brandonbraun653/DroneController/hw/Fusion360/TestPlateV1.stl

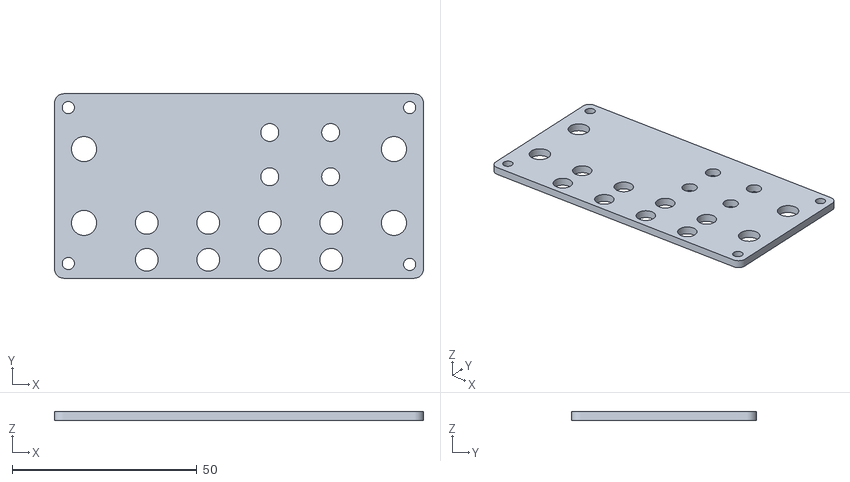
[picture p1: CAD file, 2021-05-23]
hw/Fusion360/TestPlateV1.stl
100.0 x 50.0 x 2.50
