brandonbraun653/DroneController/hw/PCBDesign/DroneController.kicad_pcb

## KiCad design hw/PCBDesign/DroneController.kicad_pcb (2021-12-31)

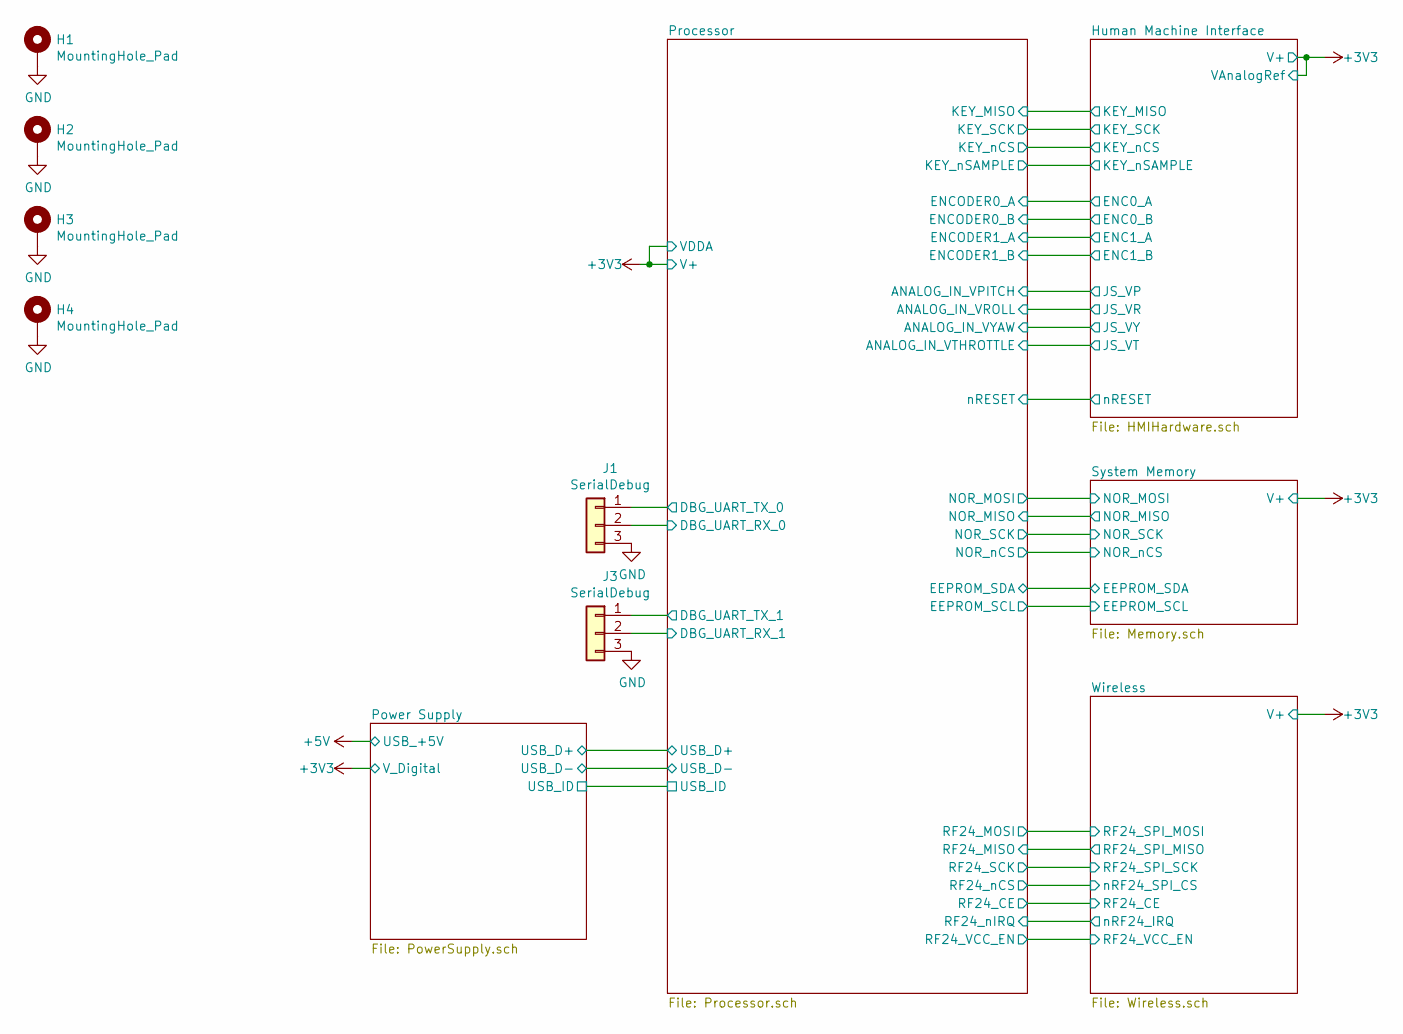
[picture p2: schematic DroneController.sch]

Parts:
H1, H2, H3, H4: MountingHole_Pad; MountingHole_3.2mm_M3_Pad_Via
J1, J3: SerialDebug; Molex_PicoBlade_53261-0371_1x03-1MP_P1.25mm_Horizontal; DigiKey WM7621CT-ND

Connections:
/Processor/DBG_UART_RX_0: J1.2; also elsewhere on the board
/Processor/DBG_UART_RX_1: J3.2; also elsewhere on the board
/Processor/DBG_UART_TX_0: J1.1; also elsewhere on the board
/Processor/DBG_UART_TX_1: J3.1; also elsewhere on the board
GND: H1.1, H2.1, H3.1, H4.1, J1.3, J3.3; also elsewhere on the board

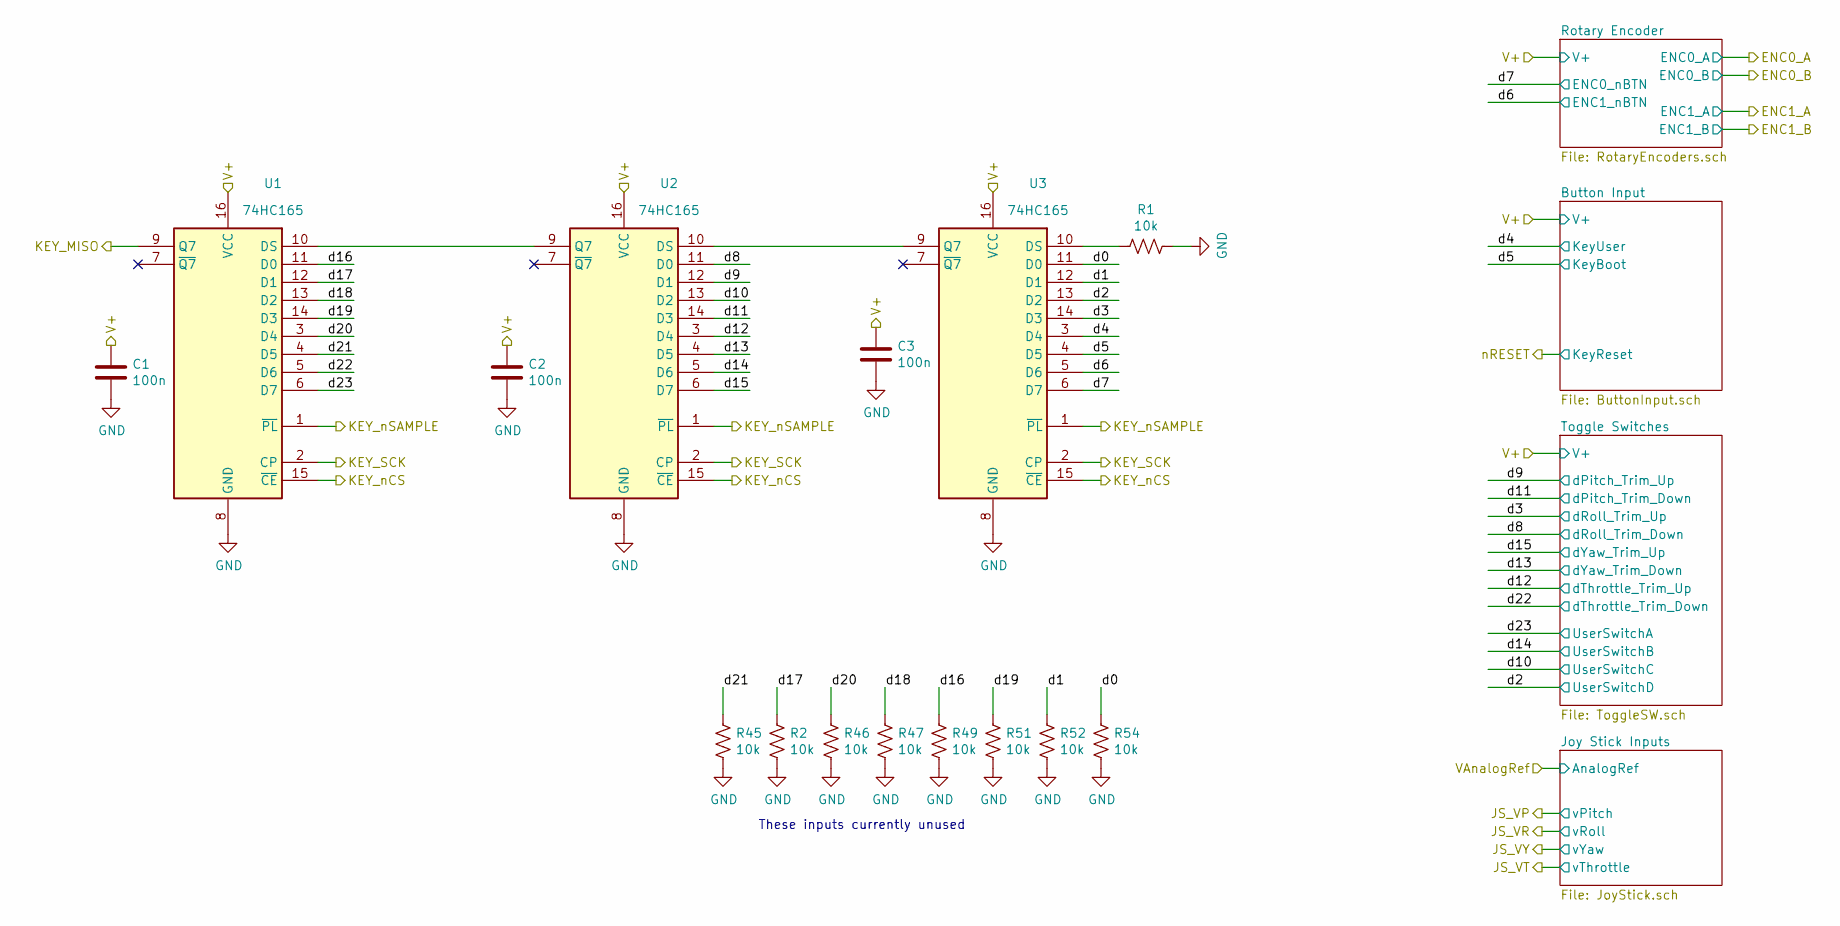
[picture p3: schematic HMIHardware.sch]

Parts:
C1, C2, C3: 100n; C_0402_1005Metric; LCSC C1525
R1, R2, R45, R46, R47, R49, R51, R52, R54: 10k; R_0402_1005Metric; LCSC C25744
U1, U2, U3: 74HC165; SOIC-16_3.9x9.9mm_P1.27mm; LCSC C5613

Connections:
+3V3: C1.1, C2.1, C3.1, U1.16 (VCC), U2.16 (VCC), U3.16 (VCC); also elsewhere on the board
/Human Machine Interface/KEY_MISO: U1.9 (Q7); also elsewhere on the board
/Human Machine Interface/KEY_SCK: U1.2 (CP), U2.2 (CP), U3.2 (CP); also elsewhere on the board
/Human Machine Interface/KEY_nCS: U1.15 (~CE), U2.15 (~CE), U3.15 (~CE); also elsewhere on the board
/Human Machine Interface/KEY_nSAMPLE: U1.1 (~PL), U2.1 (~PL), U3.1 (~PL); also elsewhere on the board
/Human Machine Interface/d0: R54.1, U3.11 (D0)
/Human Machine Interface/d1: R52.1, U3.12 (D1)
/Human Machine Interface/d2: U3.13 (D2); also elsewhere on the board
/Human Machine Interface/d3: U3.14 (D3); also elsewhere on the board
/Human Machine Interface/d4: U3.3 (D4); also elsewhere on the board
/Human Machine Interface/d5: U3.4 (D5); also elsewhere on the board
/Human Machine Interface/d6: U3.5 (D6); also elsewhere on the board
/Human Machine Interface/d7: U3.6 (D7); also elsewhere on the board
/Human Machine Interface/d8: U2.11 (D0); also elsewhere on the board
/Human Machine Interface/d9: U2.12 (D1); also elsewhere on the board
/Human Machine Interface/d10: U2.13 (D2); also elsewhere on the board
/Human Machine Interface/d11: U2.14 (D3); also elsewhere on the board
/Human Machine Interface/d12: U2.3 (D4); also elsewhere on the board
/Human Machine Interface/d13: U2.4 (D5); also elsewhere on the board
/Human Machine Interface/d14: U2.5 (D6); also elsewhere on the board
/Human Machine Interface/d15: U2.6 (D7); also elsewhere on the board
/Human Machine Interface/d16: R49.1, U1.11 (D0)
/Human Machine Interface/d17: R2.1, U1.12 (D1)
/Human Machine Interface/d18: R47.1, U1.13 (D2)
/Human Machine Interface/d19: R51.1, U1.14 (D3)
/Human Machine Interface/d20: R46.1, U1.3 (D4)
/Human Machine Interface/d21: R45.1, U1.4 (D5)
/Human Machine Interface/d22: U1.5 (D6); also elsewhere on the board
/Human Machine Interface/d23: U1.6 (D7); also elsewhere on the board
GND: C1.2, C2.2, C3.2, R1.2, R2.2, R45.2, R46.2, R47.2, R49.2, R51.2, R52.2, R54.2, U1.8 (GND), U2.8 (GND), U3.8 (GND); also elsewhere on the board
unnamed: R1.1, U3.10 (DS)
unnamed: U1.10 (DS), U2.9 (Q7)
unnamed: U2.10 (DS), U3.9 (Q7)

Notes on the sheet:
These inputs currently unused

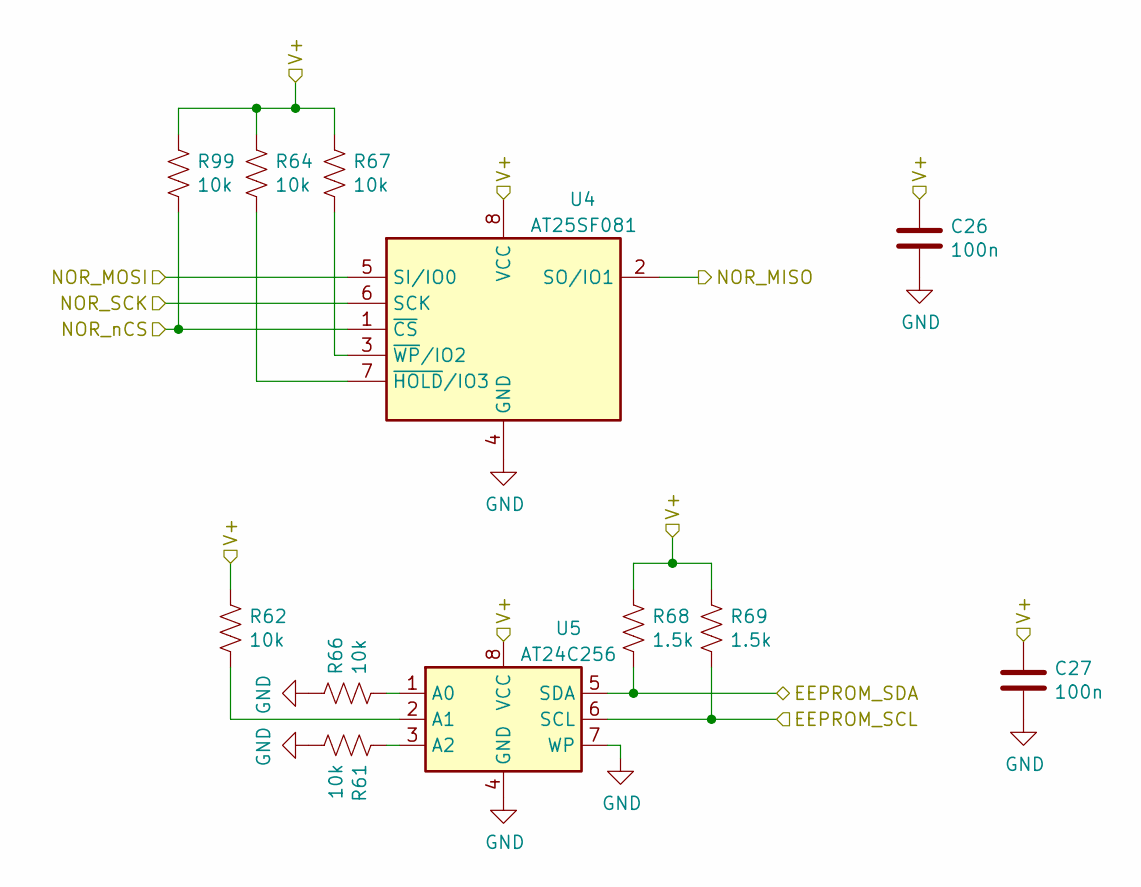
[picture p4: schematic Memory.sch]

Parts:
C26, C27: 100n; C_0402_1005Metric; LCSC C1525
R61, R62, R64, R66, R67, R99: 10k; R_0402_1005Metric; LCSC C25744
R68, R69: 1.5k; R_0402_1005Metric; LCSC C25867
U4: AT25SF081; SOIC-8_3.9x4.9mm_P1.27mm
U5: AT24C256; SOIC-8_3.9x4.9mm_P1.27mm; LCSC C6482

Connections:
+3V3: C26.1, C27.1, R62.1, R64.1, R67.1, R68.1, R69.1, R99.1, U4.8 (VCC), U5.8 (VCC); also elsewhere on the board
/Processor/EEPROM_SCL: R69.2, U5.6 (SCL); also elsewhere on the board
/Processor/EEPROM_SDA: R68.2, U5.5 (SDA); also elsewhere on the board
/Processor/NOR_MISO: U4.2 (SO/IO1); also elsewhere on the board
/Processor/NOR_MOSI: U4.5 (SI/IO0); also elsewhere on the board
/Processor/NOR_SCK: U4.6 (SCK); also elsewhere on the board
/Processor/NOR_nCS: R99.2, U4.1 (~CS); also elsewhere on the board
GND: C26.2, C27.2, R61.2, R66.1, U4.4 (GND), U5.4 (GND), U5.7 (WP); also elsewhere on the board
unnamed: R61.1, U5.3 (A2)
unnamed: R62.2, U5.2 (A1)
unnamed: R64.2, U4.7 (~HOLD~/IO3)
unnamed: R66.2, U5.1 (A0)
unnamed: R67.2, U4.3 (~WP~/IO2)

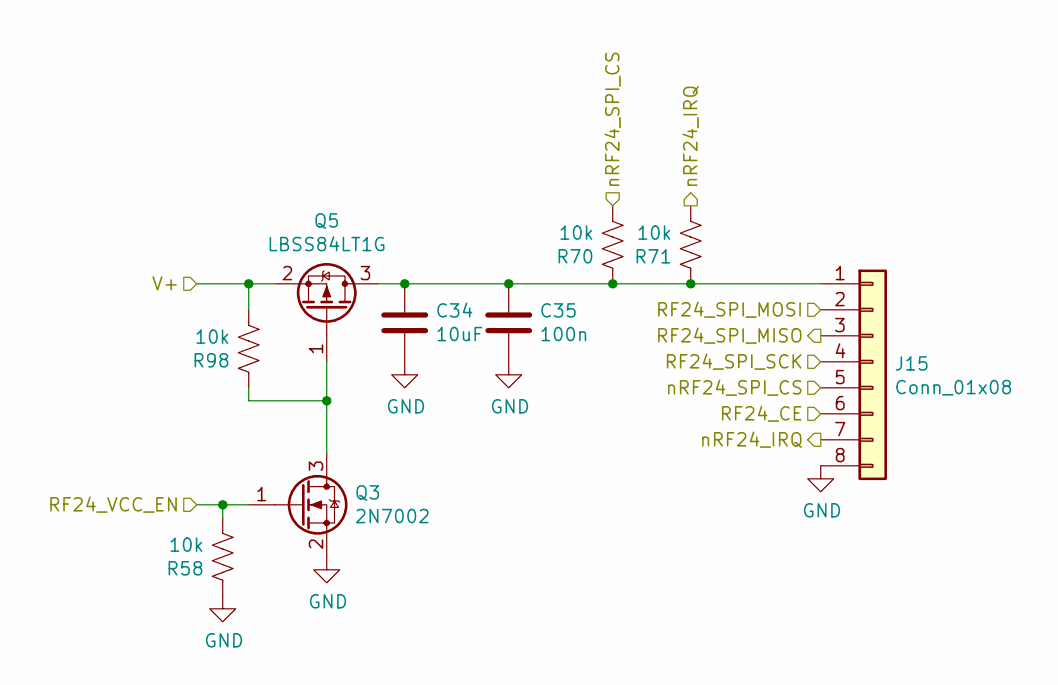
[picture p5: schematic Wireless.sch]

Parts:
C34: 10uF; C_0805_2012Metric; LCSC C28323
C35: 100n; C_0402_1005Metric; LCSC C1525
J15: Conn_01x08; Molex_PicoBlade_53261-0871_1x08-1MP_P1.25mm_Horizontal; DigiKey WM26501CT-ND
Q3: 2N7002; SOT-23; LCSC C8545
Q5: LBSS84LT1G; SOT-23; LCSC C8492
R58, R70, R71, R98: 10k; R_0402_1005Metric; LCSC C25744

Connections:
+3V3: Q5.2 (S), R98.2; also elsewhere on the board
/Processor/RF24_CE: J15.6; also elsewhere on the board
/Processor/RF24_MISO: J15.3; also elsewhere on the board
/Processor/RF24_MOSI: J15.2; also elsewhere on the board
/Processor/RF24_SCK: J15.4; also elsewhere on the board
/Processor/RF24_VCC_EN: Q3.1 (G), R58.2; also elsewhere on the board
/Processor/RF24_nCS: J15.5, R70.2; also elsewhere on the board
/Processor/RF24_nIRQ: J15.7, R71.2; also elsewhere on the board
GND: C34.2, C35.2, J15.8, Q3.2 (S), R58.1; also elsewhere on the board
unnamed: C34.1, C35.1, J15.1, Q5.3 (D), R70.1, R71.1
unnamed: Q3.3 (D), Q5.1 (G), R98.1

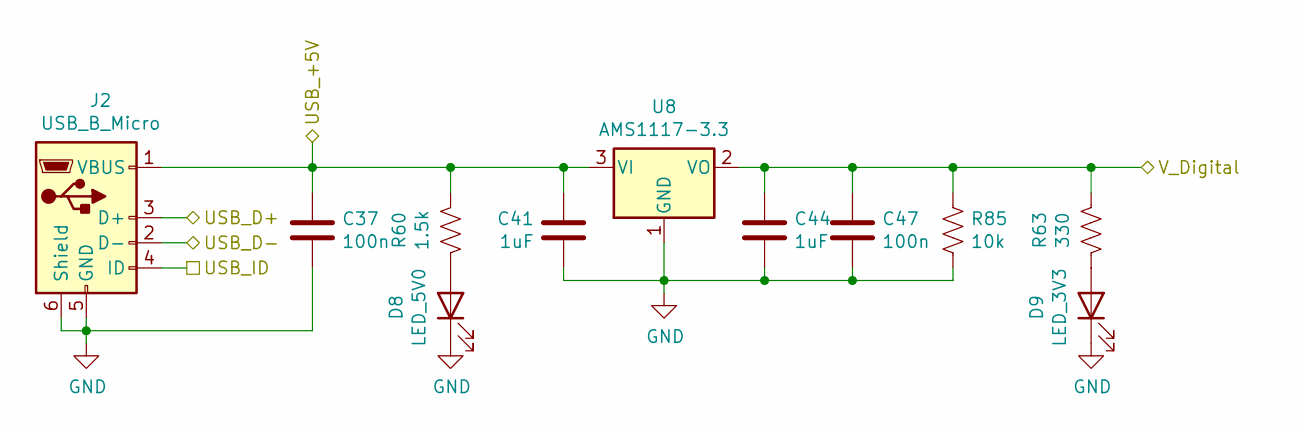
[picture p6: schematic PowerSupply.sch]

Parts:
C37, C47: 100n; C_0402_1005Metric; LCSC C1525
C41, C44: 1uF; C_0805_2012Metric; LCSC C28323
D8: LED_5V0; LED_0402_1005Metric; LCSC C72043
D9: LED_3V3; LED_0402_1005Metric; LCSC C72041
J2: USB_B_Micro; Amphenol-MicroB; DigiKey 609-4616-2-ND
R60: 1.5k; R_0402_1005Metric; LCSC C25867
R63: 330; R_0402_1005Metric; LCSC C25104
R85: 10k; R_0402_1005Metric; LCSC C25744
U8: AMS1117-3.3; SOT-223-3_TabPin2; LCSC C6186

Connections:
+3V3: C44.1, C47.1, R63.2, R85.1, U8.2 (VO); also elsewhere on the board
+5V: C37.1, C41.2, J2.1 (VBUS), R60.2, U8.3 (VI); also elsewhere on the board
/Power Supply/USB_D+: J2.3 (D+); also elsewhere on the board
/Power Supply/USB_D-: J2.2 (D-); also elsewhere on the board
/Power Supply/USB_ID: J2.4 (ID); also elsewhere on the board
GND: C37.2, C41.1, C44.2, C47.2, D8.1 (K), D9.1 (K), J2.5 (GND), J2.6 (Shield), R85.2, U8.1 (GND); also elsewhere on the board
unnamed: D8.2 (A), R60.1
unnamed: D9.2 (A), R63.1

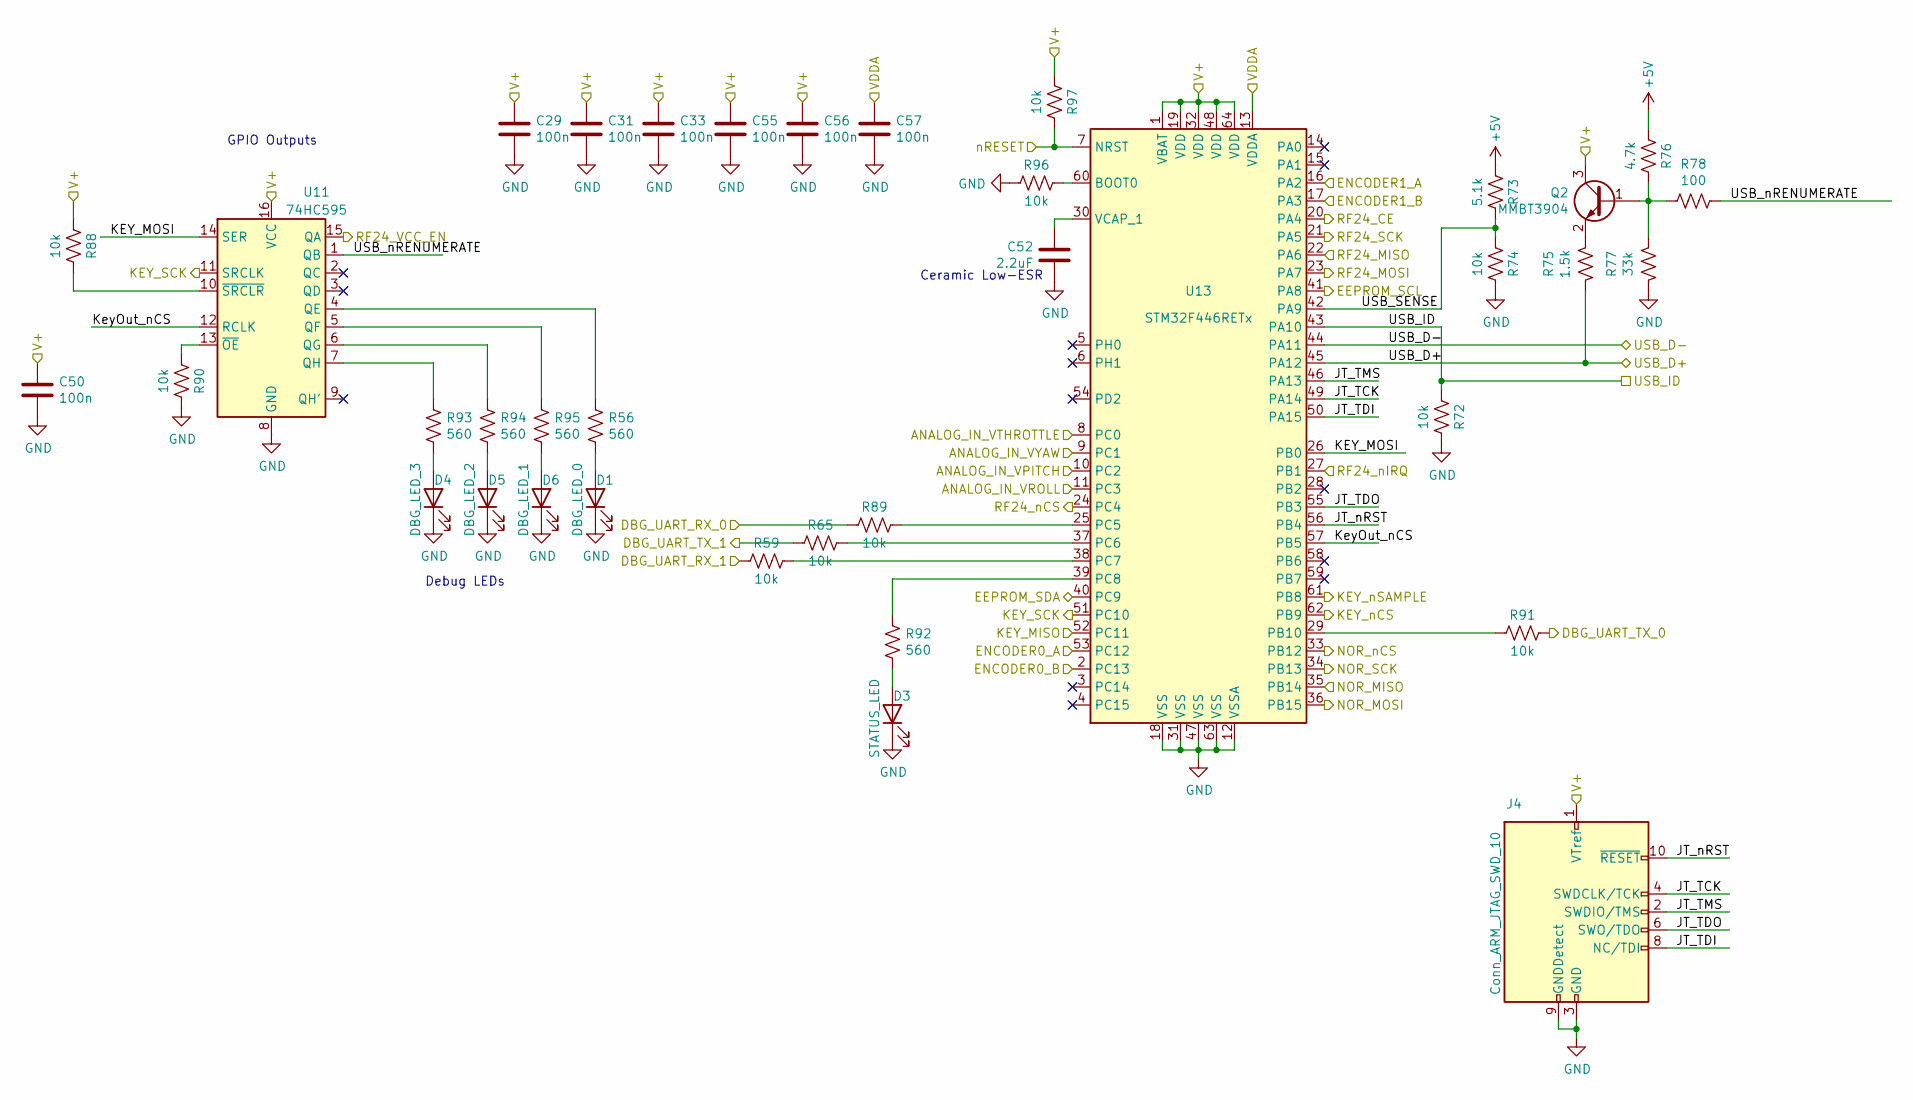
[picture p7: schematic Processor.sch]

Parts:
C29, C31, C33, C50, C55, C56, C57: 100n; C_0402_1005Metric; LCSC C1525
C52: 2.2uF; C_0805_2012Metric; LCSC C49217
D1: DBG_LED_0; LED_0603_1608Metric; LCSC C72041
D3: STATUS_LED; LED_0603_1608Metric; LCSC C72041
D4: DBG_LED_3; LED_0603_1608Metric; LCSC C72041
D5: DBG_LED_2; LED_0603_1608Metric; LCSC C72041
D6: DBG_LED_1; LED_0603_1608Metric; LCSC C72041
J4: Conn_ARM_JTAG_SWD_10; PinHeader_2x05_P1.27mm_Vertical_SMD; DigiKey 609-3695-1-ND
Q2: MMBT3904; SOT-23; LCSC C20526
R56, R92, R93, R94, R95: 560; R_0402_1005Metric; LCSC C11702
R59, R65, R72, R74, R88, R89, R90, R91, R96, R97: 10k; R_0402_1005Metric; LCSC C25744
R73: 5.1k; R_0402_1005Metric; LCSC C25905
R75: 1.5k; R_0402_1005Metric; LCSC C25867
R76: 4.7k; R_0402_1005Metric; LCSC C25900
R77: 33k; R_0402_1005Metric; LCSC C25779
R78: 100; R_0402_1005Metric; LCSC C25076
U11: 74HC595; SO-16_3.9x9.9mm_P1.27mm; LCSC C5947
U13: STM32F446RETx; LQFP-64_10x10mm_P0.5mm; LCSC C69336

Connections:
+3V3: C29.1, C31.1, C33.1, C50.1, C55.1, C56.1, C57.1, J4.1 (VTref), Q2.3 (C), R88.2, R97.2, U11.16 (VCC), U13.1 (VBAT), U13.13 (VDDA), U13.19 (VDD), U13.32 (VDD), U13.48 (VDD), U13.64 (VDD); also elsewhere on the board
+5V: R73.2, R76.2; also elsewhere on the board
/Human Machine Interface/ENC0_A: U13.53 (PC12); also elsewhere on the board
/Human Machine Interface/ENC0_B: U13.2 (PC13); also elsewhere on the board
/Human Machine Interface/ENC1_A: U13.16 (PA2); also elsewhere on the board
/Human Machine Interface/ENC1_B: U13.17 (PA3); also elsewhere on the board
/Human Machine Interface/KEY_MISO: U13.52 (PC11); also elsewhere on the board
/Human Machine Interface/KEY_SCK: U11.11 (SRCLK), U13.51 (PC10); also elsewhere on the board
/Human Machine Interface/KEY_nCS: U13.62 (PB9); also elsewhere on the board
/Human Machine Interface/KEY_nSAMPLE: U13.61 (PB8); also elsewhere on the board
/Human Machine Interface/nRESET: R97.1, U13.7 (NRST); also elsewhere on the board
/Power Supply/USB_D+: R75.1, U13.45 (PA12); also elsewhere on the board
/Power Supply/USB_D-: U13.44 (PA11); also elsewhere on the board
/Power Supply/USB_ID: R72.2, U13.43 (PA10); also elsewhere on the board
/Processor/ANALOG_IN_VPITCH: U13.10 (PC2); also elsewhere on the board
/Processor/ANALOG_IN_VROLL: U13.11 (PC3); also elsewhere on the board
/Processor/ANALOG_IN_VTHROTTLE: U13.8 (PC0); also elsewhere on the board
/Processor/ANALOG_IN_VYAW: U13.9 (PC1); also elsewhere on the board
/Processor/DBG_UART_RX_0: R89.2; also elsewhere on the board
/Processor/DBG_UART_RX_1: R59.2; also elsewhere on the board
/Processor/DBG_UART_TX_0: R91.1; also elsewhere on the board
/Processor/DBG_UART_TX_1: R65.2; also elsewhere on the board
/Processor/EEPROM_SCL: U13.41 (PA8); also elsewhere on the board
/Processor/EEPROM_SDA: U13.40 (PC9); also elsewhere on the board
/Processor/JT_TCK: J4.4 (SWDCLK/TCK), U13.49 (PA14)
/Processor/JT_TDI: J4.8 (NC/TDI), U13.50 (PA15)
/Processor/JT_TDO: J4.6 (SWO/TDO), U13.55 (PB3)
/Processor/JT_TMS: J4.2 (SWDIO/TMS), U13.46 (PA13)
/Processor/JT_nRST: J4.10 (~RESET~), U13.56 (PB4)
/Processor/KEY_MOSI: U11.14 (SER), U13.26 (PB0)
/Processor/KeyOut_nCS: U11.12 (RCLK), U13.57 (PB5)
/Processor/NOR_MISO: U13.35 (PB14); also elsewhere on the board
/Processor/NOR_MOSI: U13.36 (PB15); also elsewhere on the board
/Processor/NOR_SCK: U13.34 (PB13); also elsewhere on the board
/Processor/NOR_nCS: U13.33 (PB12); also elsewhere on the board
/Processor/RF24_CE: U13.20 (PA4); also elsewhere on the board
/Processor/RF24_MISO: U13.22 (PA6); also elsewhere on the board
/Processor/RF24_MOSI: U13.23 (PA7); also elsewhere on the board
/Processor/RF24_SCK: U13.21 (PA5); also elsewhere on the board
/Processor/RF24_VCC_EN: U11.15 (QA); also elsewhere on the board
/Processor/RF24_nCS: U13.24 (PC4); also elsewhere on the board
/Processor/RF24_nIRQ: U13.27 (PB1); also elsewhere on the board
/Processor/USB_SENSE: R73.1, R74.2, U13.42 (PA9)
/Processor/USB_nRENUMERATE: R78.1, U11.1 (QB)
GND: C29.2, C31.2, C33.2, C50.2, C52.1, C55.2, C56.2, C57.2, D1.1 (K), D3.1 (K), D4.1 (K), D5.1 (K), D6.1 (K), J4.3 (GND), J4.5 (GND), J4.9 (GNDDetect), R72.1, R74.1, R77.1, R90.1, R96.2, U11.8 (GND), U13.12 (VSSA), U13.18 (VSS), U13.31 (VSS), U13.47 (VSS), U13.63 (VSS); also elsewhere on the board
unnamed: C52.2, U13.30 (VCAP_1)
unnamed: D1.2 (A), R56.1
unnamed: D3.2 (A), R92.1
unnamed: D4.2 (A), R93.1
unnamed: D5.2 (A), R94.1
unnamed: D6.2 (A), R95.1
unnamed: Q2.1 (B), R76.1, R77.2, R78.2
unnamed: Q2.2 (E), R75.2
unnamed: R56.2, U11.4 (QE)
unnamed: R59.1, U13.38 (PC7)
unnamed: R65.1, U13.37 (PC6)
unnamed: R88.1, U11.10 (~SRCLR)
unnamed: R89.1, U13.25 (PC5)
unnamed: R90.2, U11.13 (~OE)
unnamed: R91.2, U13.29 (PB10)
unnamed: R92.2, U13.39 (PC8)
unnamed: R93.2, U11.7 (QH)
unnamed: R94.2, U11.6 (QG)
unnamed: R95.2, U11.5 (QF)
unnamed: R96.1, U13.60 (BOOT0)

Notes on the sheet:
Ceramic Low-ESR
GPIO Outputs
Debug LEDs

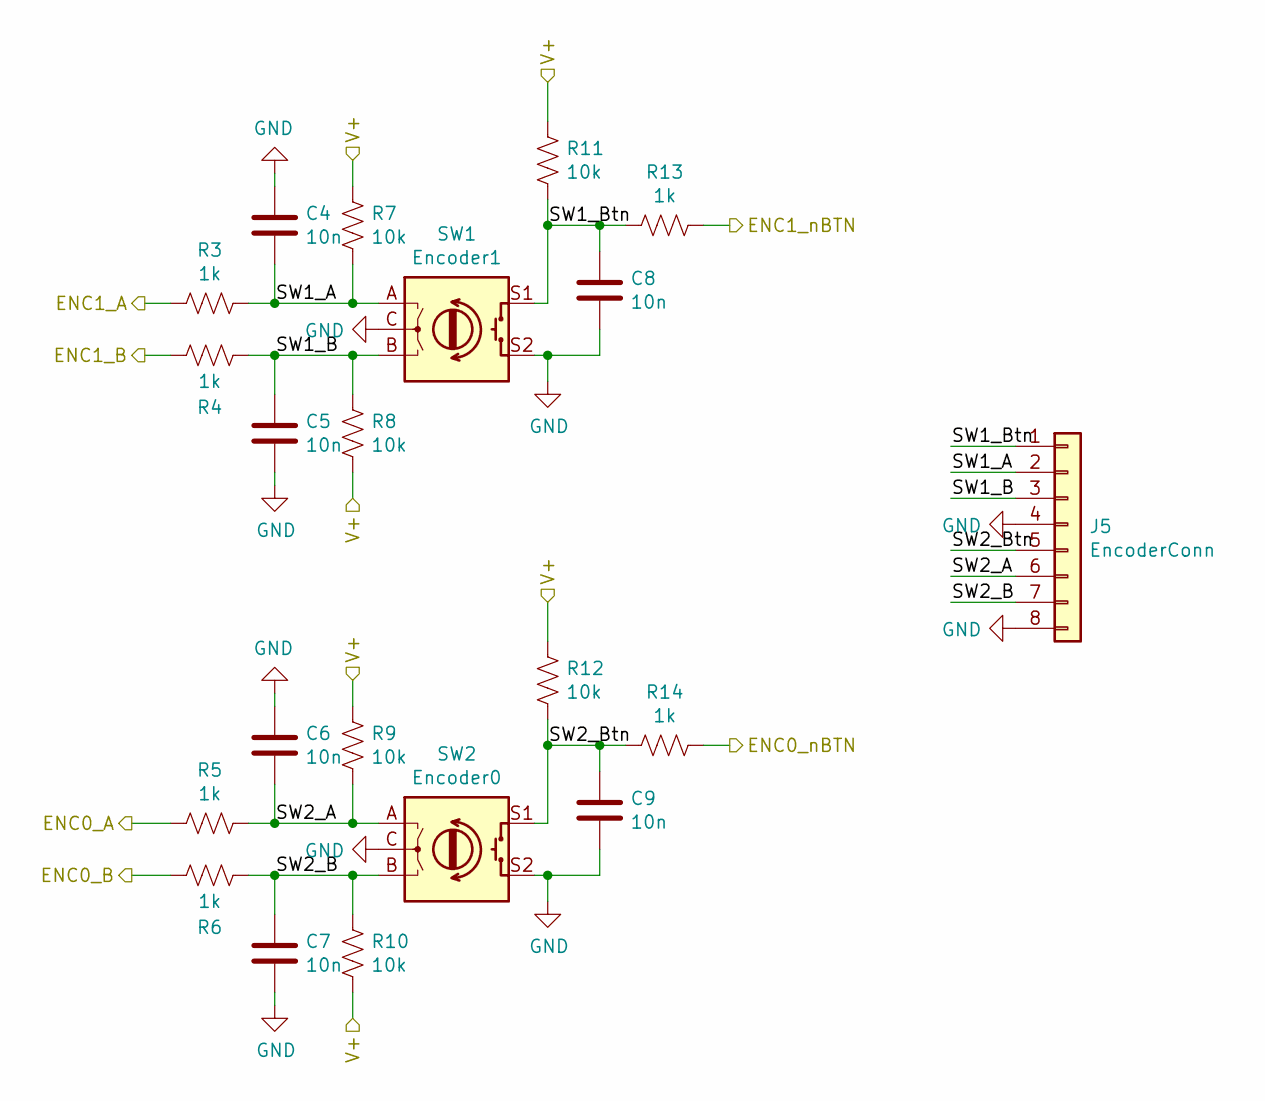
[picture p8: schematic RotaryEncoders.sch]

Parts:
C4, C5, C6, C7, C8, C9: 10n; C_0402_1005Metric; LCSC C15195
J5: EncoderConn; Molex_PicoBlade_53261-0871_1x08-1MP_P1.25mm_Horizontal; DigiKey WM26501CT-ND
R3, R4, R5, R6, R13, R14: 1k; R_0402_1005Metric; LCSC C11702
R7, R8, R9, R10, R11, R12: 10k; R_0402_1005Metric; LCSC C25744
SW1: Encoder1
SW2: Encoder0

Connections:
+3V3: R7.1, R8.2, R9.1, R10.2, R11.1, R12.1; also elsewhere on the board
/Human Machine Interface/ENC0_A: R5.2; also elsewhere on the board
/Human Machine Interface/ENC0_B: R6.2; also elsewhere on the board
/Human Machine Interface/ENC1_A: R3.2; also elsewhere on the board
/Human Machine Interface/ENC1_B: R4.2; also elsewhere on the board
/Human Machine Interface/Rotary Encoder/SW1_A: C4.2, J5.2, R3.1, R7.2, SW1.A
/Human Machine Interface/Rotary Encoder/SW1_B: C5.1, J5.3, R4.1, R8.1, SW1.B
/Human Machine Interface/Rotary Encoder/SW1_Btn: C8.1, J5.1, R11.2, R13.2, SW1.S1
/Human Machine Interface/Rotary Encoder/SW2_A: C6.2, J5.6, R5.1, R9.2, SW2.A
/Human Machine Interface/Rotary Encoder/SW2_B: C7.1, J5.7, R6.1, R10.1, SW2.B
/Human Machine Interface/Rotary Encoder/SW2_Btn: C9.1, J5.5, R12.2, R14.2, SW2.S1
/Human Machine Interface/d6: R13.1; also elsewhere on the board
/Human Machine Interface/d7: R14.1; also elsewhere on the board
GND: C4.1, C5.2, C6.1, C7.2, C8.2, C9.2, J5.4, J5.8, SW1.C, SW1.S2, SW2.C, SW2.S2; also elsewhere on the board

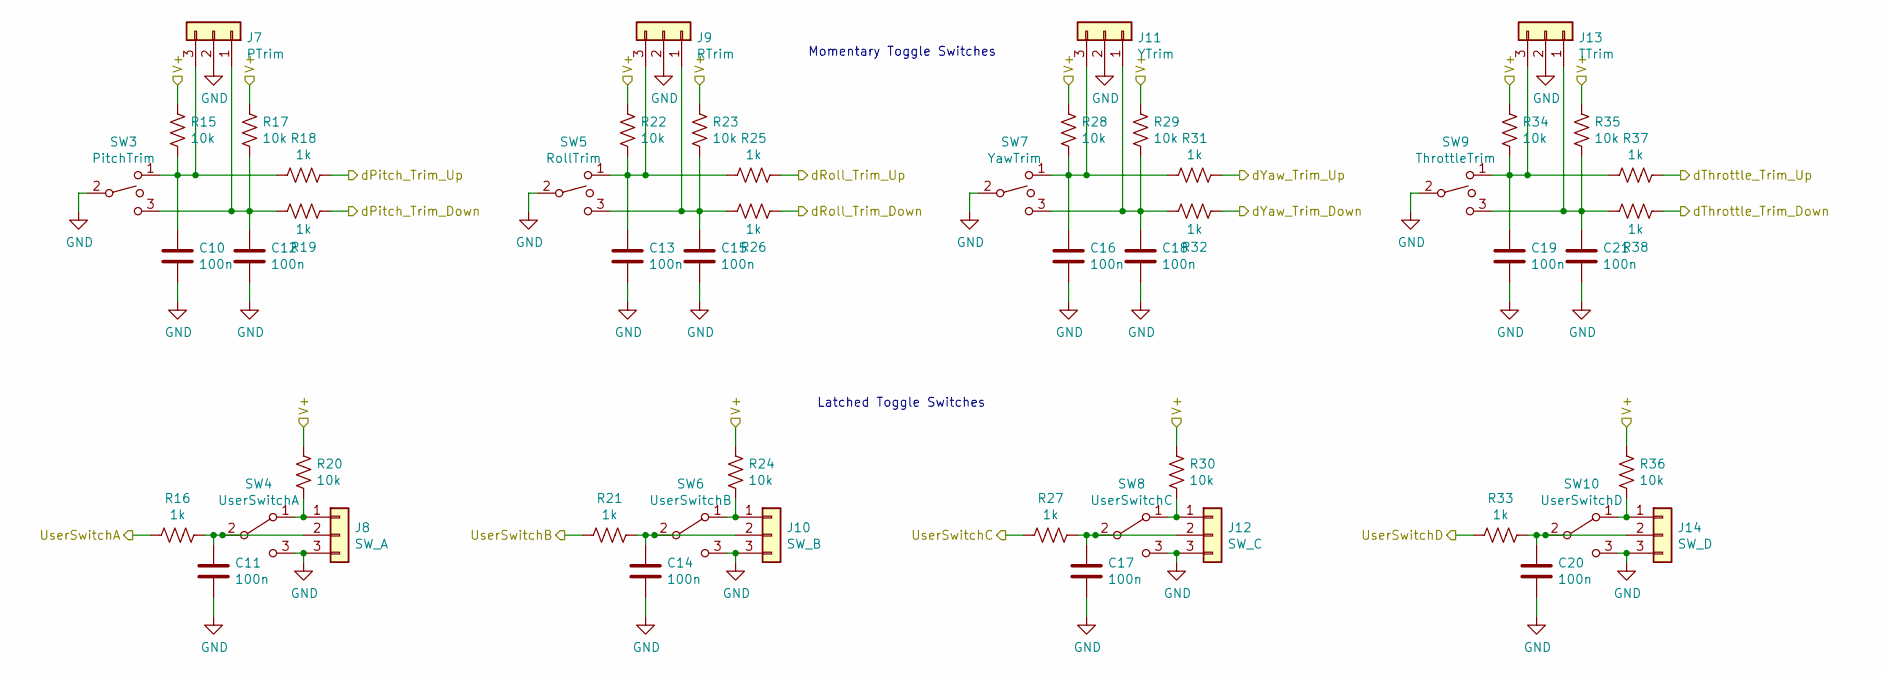
[picture p9: schematic ToggleSW.sch]

Parts:
C10, C11, C12, C13, C14, C15, C16, C17, C18, C19, C20, C21: 100n; C_0402_1005Metric; LCSC C1525
J7: PTrim; Molex_PicoBlade_53261-0371_1x03-1MP_P1.25mm_Horizontal; DigiKey WM7621CT-ND
J8: SW_A; Molex_PicoBlade_53261-0371_1x03-1MP_P1.25mm_Horizontal; DigiKey WM7621CT-ND
J9: RTrim; Molex_PicoBlade_53261-0371_1x03-1MP_P1.25mm_Horizontal; DigiKey WM7621CT-ND
J10: SW_B; Molex_PicoBlade_53261-0371_1x03-1MP_P1.25mm_Horizontal; DigiKey WM7621CT-ND
J11: YTrim; Molex_PicoBlade_53261-0371_1x03-1MP_P1.25mm_Horizontal; DigiKey WM7621CT-ND
J12: SW_C; Molex_PicoBlade_53261-0371_1x03-1MP_P1.25mm_Horizontal; DigiKey WM7621CT-ND
J13: TTrim; Molex_PicoBlade_53261-0371_1x03-1MP_P1.25mm_Horizontal; DigiKey WM7621CT-ND
J14: SW_D; Molex_PicoBlade_53261-0371_1x03-1MP_P1.25mm_Horizontal; DigiKey WM7621CT-ND
R15, R17, R20, R22, R23, R24, R28, R29, R30, R34, R35, R36: 10k; R_0402_1005Metric; LCSC C25744
R16, R18, R19, R21, R25, R26, R27, R31, R32, R33, R37, R38: 1k; R_0402_1005Metric; LCSC C11702
SW3: PitchTrim
SW4: UserSwitchA
SW5: RollTrim
SW6: UserSwitchB
SW7: YawTrim
SW8: UserSwitchC
SW9: ThrottleTrim
SW10: UserSwitchD

Connections:
+3V3: R15.1, R17.1, R20.1, R22.1, R23.1, R24.1, R28.1, R29.1, R30.1, R34.1, R35.1, R36.1; also elsewhere on the board
/Human Machine Interface/d2: R33.2; also elsewhere on the board
/Human Machine Interface/d3: R25.1; also elsewhere on the board
/Human Machine Interface/d8: R26.2; also elsewhere on the board
/Human Machine Interface/d9: R18.1; also elsewhere on the board
/Human Machine Interface/d10: R27.2; also elsewhere on the board
/Human Machine Interface/d11: R19.2; also elsewhere on the board
/Human Machine Interface/d12: R37.1; also elsewhere on the board
/Human Machine Interface/d13: R32.2; also elsewhere on the board
/Human Machine Interface/d14: R21.2; also elsewhere on the board
/Human Machine Interface/d15: R31.1; also elsewhere on the board
/Human Machine Interface/d22: R38.2; also elsewhere on the board
/Human Machine Interface/d23: R16.2; also elsewhere on the board
GND: C10.2, C11.2, C12.2, C13.2, C14.2, C15.2, C16.2, C17.2, C18.2, C19.2, C20.2, C21.2, J7.2, J8.3, J9.2, J10.3, J11.2, J12.3, J13.2, J14.3, SW3.2, SW4.3 (C), SW5.2, SW6.3 (C), SW7.2, SW8.3 (C), SW9.2, SW10.3 (C); also elsewhere on the board
unnamed: C10.1, J7.3, R15.2, R18.2, SW3.1
unnamed: C11.1, J8.2, R16.1, SW4.2 (B)
unnamed: C12.1, J7.1, R17.2, R19.1, SW3.3
unnamed: C13.1, J9.3, R22.2, R25.2, SW5.1
unnamed: C14.1, J10.2, R21.1, SW6.2 (B)
unnamed: C15.1, J9.1, R23.2, R26.1, SW5.3
unnamed: C16.1, J11.3, R28.2, R31.2, SW7.1
unnamed: C17.1, J12.2, R27.1, SW8.2 (B)
unnamed: C18.1, J11.1, R29.2, R32.1, SW7.3
unnamed: C19.1, J13.3, R34.2, R37.2, SW9.1
unnamed: C20.1, J14.2, R33.1, SW10.2 (B)
unnamed: C21.1, J13.1, R35.2, R38.1, SW9.3
unnamed: J8.1, R20.2, SW4.1 (A)
unnamed: J10.1, R24.2, SW6.1 (A)
unnamed: J12.1, R30.2, SW8.1 (A)
unnamed: J14.1, R36.2, SW10.1 (A)

Notes on the sheet:
Momentary Toggle Switches
Latched Toggle Switches

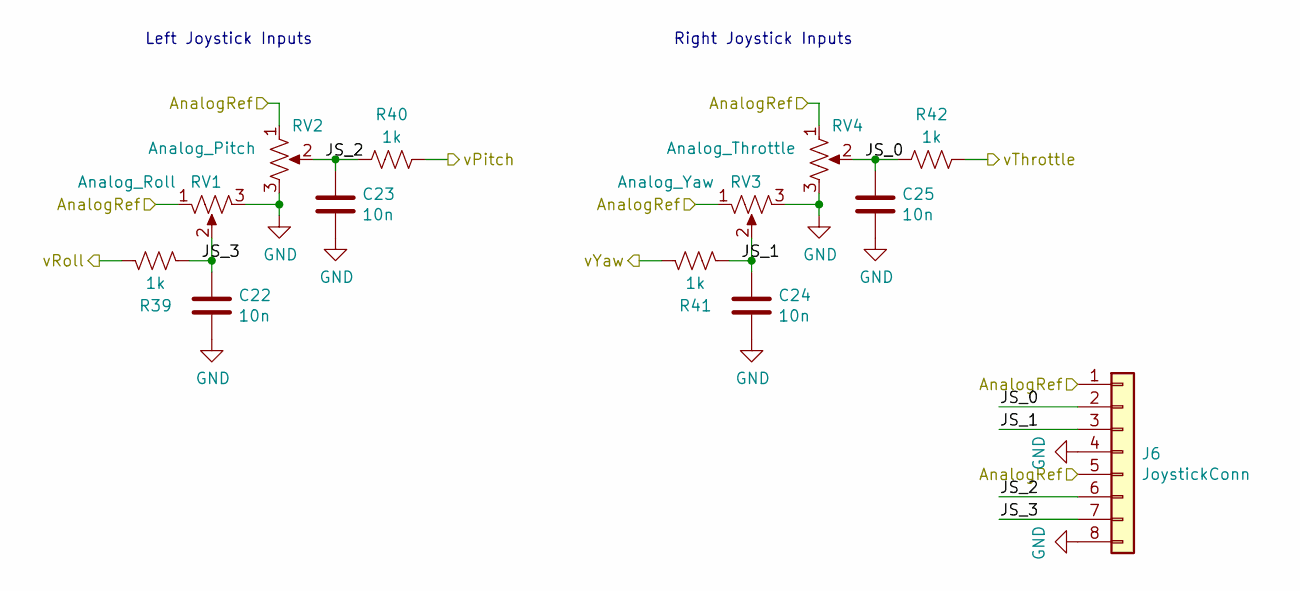
[picture p10: schematic JoyStick.sch]

Parts:
C22, C23, C24, C25: 10n; C_0402_1005Metric; LCSC C15195
J6: JoystickConn; Molex_PicoBlade_53261-0871_1x08-1MP_P1.25mm_Horizontal; DigiKey WM26501CT-ND
R39, R40, R41, R42: 1k; R_0402_1005Metric; LCSC C11702
RV1: Analog_Roll
RV2: Analog_Pitch
RV3: Analog_Yaw
RV4: Analog_Throttle

Connections:
+3V3: J6.1, J6.5, RV1.1, RV2.1, RV3.1, RV4.1; also elsewhere on the board
/Human Machine Interface/Joy Stick Inputs/JS_0: C25.1, J6.2, R42.1, RV4.2
/Human Machine Interface/Joy Stick Inputs/JS_1: C24.1, J6.3, R41.2, RV3.2
/Human Machine Interface/Joy Stick Inputs/JS_2: C23.1, J6.6, R40.1, RV2.2
/Human Machine Interface/Joy Stick Inputs/JS_3: C22.1, J6.7, R39.2, RV1.2
/Processor/ANALOG_IN_VPITCH: R40.2; also elsewhere on the board
/Processor/ANALOG_IN_VROLL: R39.1; also elsewhere on the board
/Processor/ANALOG_IN_VTHROTTLE: R42.2; also elsewhere on the board
/Processor/ANALOG_IN_VYAW: R41.1; also elsewhere on the board
GND: C22.2, C23.2, C24.2, C25.2, J6.4, J6.8, RV1.3, RV2.3, RV3.3, RV4.3; also elsewhere on the board

Notes on the sheet:
Left Joystick Inputs
Right Joystick Inputs

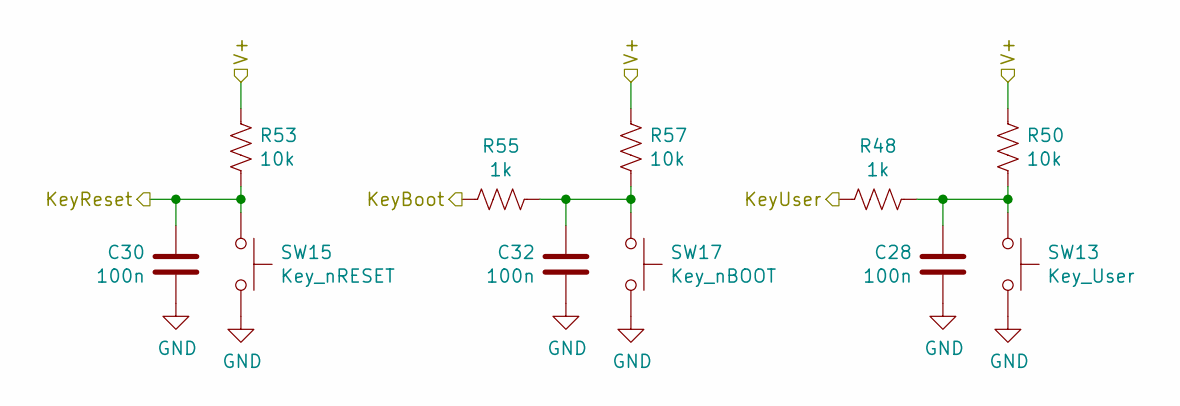
[picture p11: schematic ButtonInput.sch]

Parts:
C28, C30, C32: 100n; C_0402_1005Metric; LCSC C1525
R48, R55: 1k; R_0402_1005Metric; LCSC C11702
R50, R53, R57: 10k; R_0402_1005Metric; LCSC C25744
SW13: Key_User; SW_SPST_PTS810; DigiKey CKN10504CT-ND
SW15: Key_nRESET; SW_SPST_PTS810; DigiKey CKN10504CT-ND
SW17: Key_nBOOT; SW_SPST_PTS810; DigiKey CKN10504CT-ND

Connections:
+3V3: R50.1, R53.1, R57.1; also elsewhere on the board
/Human Machine Interface/d4: R48.2; also elsewhere on the board
/Human Machine Interface/d5: R55.2; also elsewhere on the board
/Human Machine Interface/nRESET: C30.2, R53.2, SW15.1; also elsewhere on the board
GND: C28.1, C30.1, C32.1, SW13.2, SW15.2, SW17.2; also elsewhere on the board
unnamed: C28.2, R48.1, R50.2, SW13.1
unnamed: C32.2, R55.1, R57.2, SW17.1
