brandonbraun653/DroneController/hw/PCBDesign/DroneController.kicad_pcb

## KiCad design hw/PCBDesign/DroneController.kicad_pcb (continued)

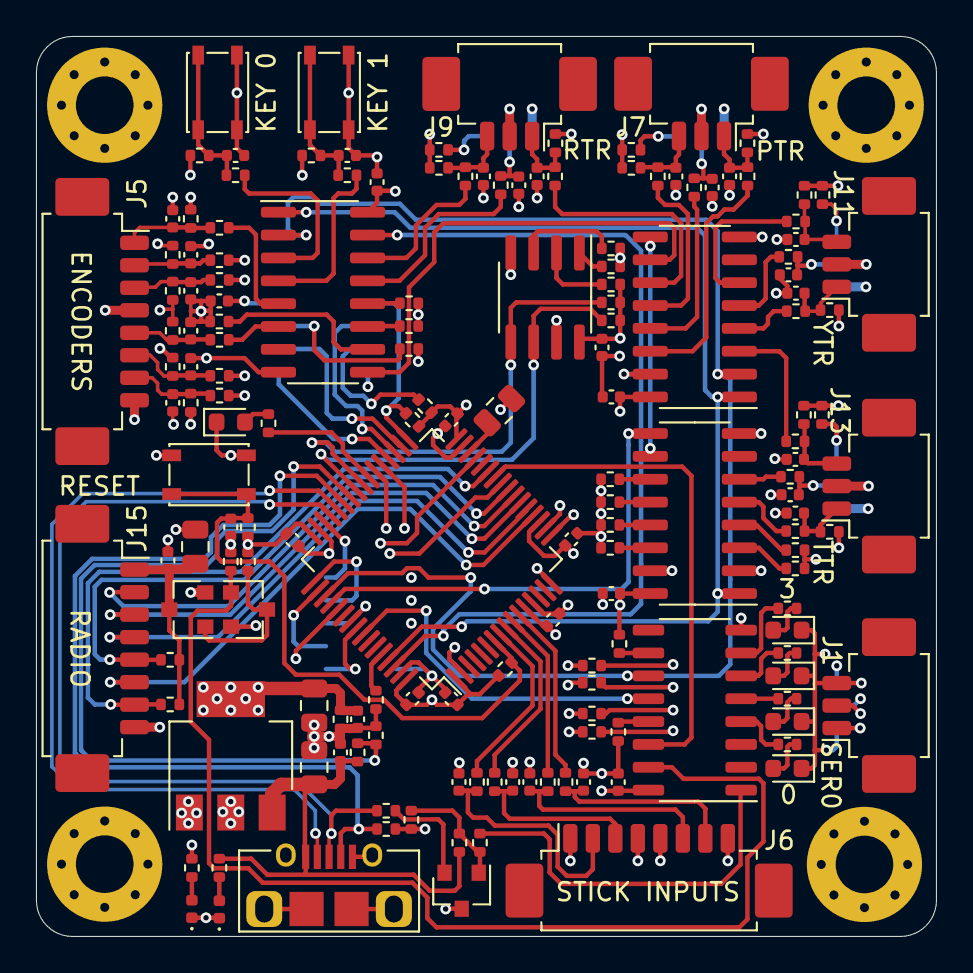
[picture p12: board DroneController.kicad_pcb from above]

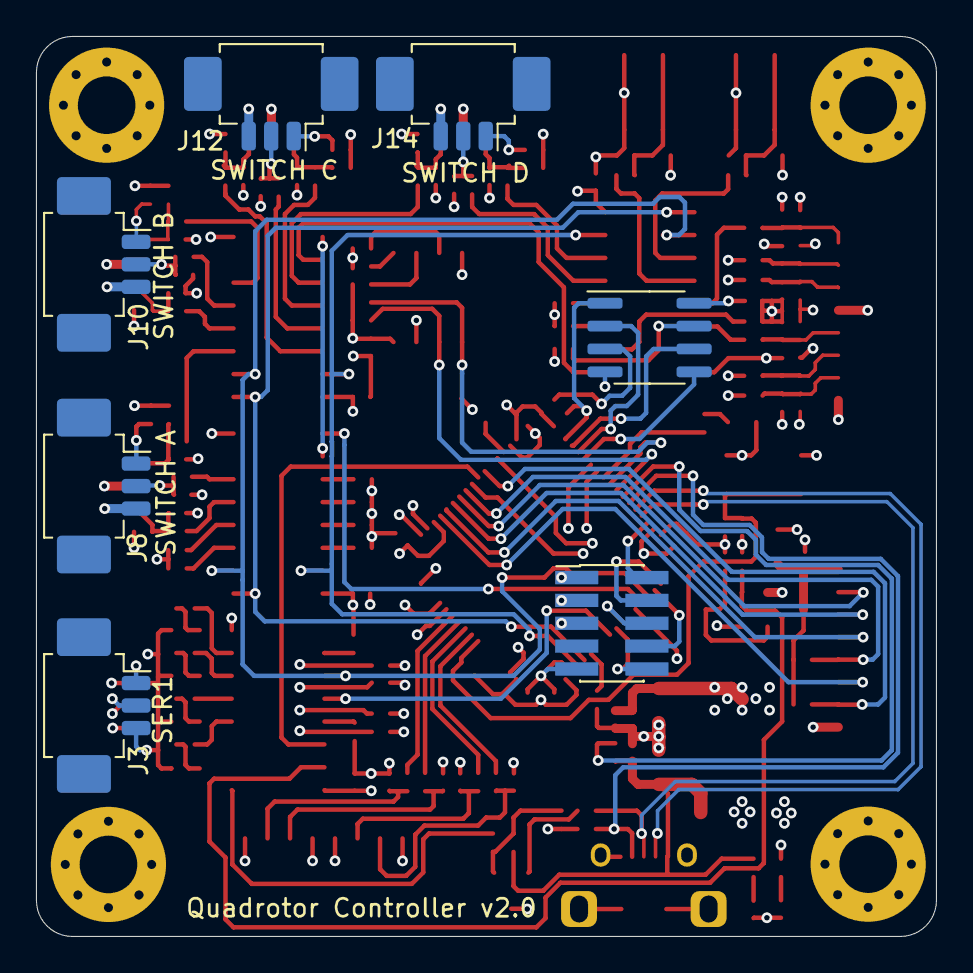
[picture p13: board DroneController.kicad_pcb from below]

Board: 4 copper layers, 50.0 x 50.0 mm, 173 parts (7 on the bottom side), 129 nets.
