brandonbraun653/DroneController/hw/CubeMX/CubeMX.ioc

Mcu.UserName=STM32F446RETx
PA0-WKUP.Signal=ADCx_IN0
PA1.Signal=ADCx_IN1
PA10.GPIO_Label=Encoder1_A
PA10.Signal=GPXTI10
PA11.Signal=USB_OTG_FS_DM
PA12.Signal=USB_OTG_FS_DP
PA13.Signal=SYS_JTMS-SWDIO
PA14.Signal=SYS_JTCK-SWCLK
PA15.Signal=SYS_JTDI
PA2.Signal=ADCx_IN2
PA3.Signal=ADCx_IN3
PA4.GPIO_Label=RF24_CE
PA4.Signal=GPIO_Output
PA5.Signal=SPI1_SCK
PA6.Signal=SPI1_MISO
PA7.Signal=SPI1_MOSI
PA8.Signal=I2C3_SCL
PA9.GPIO_Label=Encoder1_B
PA9.Signal=GPIO_Input
PB0.Signal=SPI3_MOSI
PB1.GPIO_Label=RF24_IRQ
PB1.Signal=GPXTI1
PB10.GPIO_Label=USART3_DBG_TX
PB10.Signal=USART3_TX
PB12.GPIO_Label=NOR_CSm
PB12.Signal=GPIO_Output
PB13.Signal=SPI2_SCK
PB14.Signal=SPI2_MISO
PB15.Signal=SPI2_MOSI
PB3.Signal=SYS_JTDO-SWO
PB4.Signal=SYS_JTRST
PB5.GPIO_Label=KeyOut_nCS
PB5.Signal=GPIO_Output
PB6.Signal=S_TIM4_CH1
PB7.Signal=S_TIM4_CH2
PB8.GPIO_Label=Key_nSample
PB8.Signal=GPIO_Output
PB9.GPIO_Label=Key_nCS
PB9.Signal=GPIO_Output
PC0.Signal=ADCx_IN10
PC1.Signal=ADCx_IN11
PC10.Signal=SPI3_SCK
PC11.Signal=SPI3_MISO
PC12.GPIO_Label=Encoder0_B
PC12.Signal=GPIO_Input
PC2.Signal=ADCx_IN12
PC3.Signal=ADCx_IN13
PC4.GPIO_Label=RF24_CS
PC4.Signal=GPIO_Output
PC5.GPIO_Label=USART3_DBG_RX
PC5.Signal=USART3_RX
PC6.GPIO_Label=USART6_BT_TX
PC6.Signal=USART6_TX
PC7.GPIO_Label=USART6_BT_RX
PC7.Signal=USART6_RX
PC8.GPIO_Label=BT_IRQ
PC8.Signal=GPXTI8
PC9.Signal=I2C3_SDA
PD2.GPIO_Label=Encoder0_A
PD2.Signal=GPXTI2
PH0-OSC_IN.Signal=RCC_OSC_IN
PH1-OSC_OUT.Signal=RCC_OSC_OUT
