brandonbraun653/DroneController/src/controller/ctrl_types.hpp

/******************************************************************************
 *  File Name:
 *    ctrl_types.hpp
 *
 *  Description:
 *    Types used in the controller module
 *
 *  2022 | Brandon Braun | brandonbraun653@gmail.com
 *****************************************************************************/

#pragma once
#ifndef DC_CONTROLLER_TYPES_HPP
#define DC_CONTROLLER_TYPES_HPP



namespace DC::CTRL
{
}  // namespace DC::CTRL

#endif  /* !DC_CONTROLLER_TYPES_HPP */
