brandonbraun653/DroneController/src/io/gpio_driver.hpp

/********************************************************************************
 *  File Name:
 *    gpio_driver.hpp
 *
 *  Description:
 *    Driver for reading/writing to GPIO through shift registers
 *
 *  2021 | Brandon Braun | brandonbraun653@gmail.com
 *******************************************************************************/

#pragma once
#ifndef DC_GPIO_DRIVER_HPP
#define DC_GPIO_DRIVER_HPP

/* Project Includes */
#include <src/io/pin_mapping.hpp>

namespace DC::GPIO
{
  /*-------------------------------------------------------------------------------
  Public Functions
  -------------------------------------------------------------------------------*/
  void setShiftRegister( const OutputPin pin );
  void clearShiftRegister( const OutputPin pin );
  bool getShiftRegister( const InputPin pin );

}  // namespace DC::GPIO

#endif  /* !DC_GPIO_DRIVER_HPP */
