brandonbraun653/DroneController/src/system/power_up.cpp

/********************************************************************************
 *  File Name:
 *    power_up.cpp
 *
 *  Description:
 *    Powers up the board modules and peripherals
 *
 *  2021 | Brandon Braun | brandonbraun653@gmail.com
 *******************************************************************************/

/* Aurora Includes */
#include <Aurora/logging>

/* Project Includes */
#include <src/hmi/hmi_encoder.hpp>
#include <src/hmi/hmi_sticks.hpp>
#include <src/hmi/hmi_discrete.hpp>
#include <src/io/shift_register_driver.hpp>
#include <src/registry/reg_intf.hpp>
#include <src/system/power_up.hpp>
#include <src/usb/usb_system.hpp>
#include <src/utility/logger.hpp>
#include <src/utility/serial_output.hpp>
#include <src/wireless/bluetooth/bt_driver.hpp>
#include <src/wireless/rf24/rf_driver.hpp>

namespace DC::SYS
{
  /*-------------------------------------------------------------------------------
  Public Functions
  -------------------------------------------------------------------------------*/
  void powerUpModules()
  {
    /*-------------------------------------------------
    Power up serial resources first for debug functions
    -------------------------------------------------*/
    powerUpSerial();

    /*-------------------------------------------------
    Attempt to mount the file system, which allows the
    registry to initialize properly.
    -------------------------------------------------*/
    powerUpFileSystem();

    /*-------------------------------------------------
    Power up the shift register processing
    -------------------------------------------------*/
    DC::GPIO::SR::init();

    /*-------------------------------------------------
    Power up the bluetooth driver
    -------------------------------------------------*/
    DC::RF::BT::initDriver();

    /*-------------------------------------------------
    Power up the radio driver
    -------------------------------------------------*/
    DC::RF::RF24::initDriver();

    /*-------------------------------------------------
    Power up the HMI drivers
    -------------------------------------------------*/
    DC::HMI::JoyStick::initHWDriver();

    /*-------------------------------------------------
    Power up the encoder
    -------------------------------------------------*/
    DC::HMI::Encoder::initialize();

    /*-------------------------------------------------
    Power up the discrete inputs
    -------------------------------------------------*/
    DC::HMI::Discrete::initialize();

    /*-------------------------------------------------
    Power up USB
    -------------------------------------------------*/
    //DC::USB::initialize();
  }


  void powerUpSerial()
  {
    using namespace Aurora::Logging;

    /*-------------------------------------------------
    Initialize the serial hardware channel
    -------------------------------------------------*/
    UTL::initializeSerial();

    /*-------------------------------------------------
    Turn on logger functionality (depends on serial)
    -------------------------------------------------*/
    UTL::initializeLogger( Level::LVL_DEBUG );
    LOG_DEBUG( "Power on device\r\n" );
  }


  void powerUpFileSystem()
  {
    using namespace Aurora::Logging;

    /*-------------------------------------------------
    Mount the file system
    -------------------------------------------------*/
    if( !REG::initialize() )
    {
      LOG_ERROR( "Failed to mount registry\r\n" );
    }
  }
}    // namespace DC::SYS
