brandonbraun653/DroneController/(commit log)

2020-12-17 Added core driver libraries
2020-12-21 Integrated uGFX with the ST7735 driver
2020-12-29 Added thread for radio link. Started integration tasks
2020-12-30 Add skeleton for project specific networking driver
2020-12-30 Redirected the initialization sequence to the RF driver
2021-01-02 Test out handler for TX -> MAX_RT fail
    [rf_driver.hpp, tsk_radio.cpp]
2021-01-02 Added test HMI button for triggering packet transfers
2021-01-09 Added core yaffs integration library
    Weird state
    Actually add the Yaffs source code
    Pull up submodues
    Resolve merge conflict
    [tsk_common.cpp, tsk_common.hpp, tsk_file_system.cpp, tsk_file_system.hpp, tsk_monitor.cpp]
2021-01-10 Removed all shared_ptr interfaces to HW drivers
2021-01-11 Pull up submodules. More integration of F4 drivers
2021-01-12 Test out new RCC driver model
2021-01-15 Pull up submodules. Interrupt callback registry tests
2021-01-25 Pull up submodules. Enable SPI driver
2021-01-26 Pull up submodules
    [results.csv]
2021-01-26 Update gitignore
    [results.csv]
2021-01-29 Pull up submodules. Working F4 SPI
2021-01-29 Rework the initialization structure
    [board_map.cpp, board_map.hpp, power_up.cpp, power_up.hpp, reg_driver.cpp, reg_intf.hpp, reg_types.hpp]
2021-01-31 Pull up submodules. Integrate first cut of database/datastore
2021-02-05 Pull up submodules. Test out button sense
2021-02-06 Validate rotary encoder inputs
2021-02-10 Get the simulator to start all threads
2021-02-11 Refactor threading
2021-02-13 Simulator threads booting properly now
2021-02-13 Working virtual GPIO driver
2021-02-14 Reworked the registry and filesystem to be closer to production interfaces
    [reg_driver.cpp, reg_files.hpp, reg_intf.hpp, sys_boot_count.cpp, sys_config.cpp, sys_config.hpp, tsk_file_system.cpp, tsk_hmi.cpp]
2021-02-14 Integrated virtual SPI driver. Removed accidental binary tracking
2021-02-18 Working networked SPI sim driver
2021-02-19 Turn back on radio with initial virtual driver stubs
2021-02-20 Get the millis functionality working
2021-02-21 Start working on new network driver approach
2021-02-21 Refactored driver working on sim again
2021-02-21 Use static thread allocation on network driver
2021-02-23 Pull up submodules. Fix thread lock on tx
    [tsk_radio.cpp]
2021-03-07 Add initial PCB project
    [DroneContrller.sch, DroneController.kicad_pcb, HMIHardware.sch, Memory.sch, PowerSupply.sch, Processor.sch]
2021-03-07 Fill out a lot of the board schematic
    [AudioOut.sch, ButtonInput.sch, DroneContrller.sch, DroneController.sch, HMIHardware.sch, JoyStick.sch, Memory.sch, PowerSupply.sch]
2021-03-09 Add HMI input circuitry
    [AudioOut.sch, HMIHardware.sch, JoyStick.sch, ToggleSW.sch, Wireless.sch]
2021-03-09 Routed JTAG and power to the processor
    [Processor.sch]
2021-03-09 Planned out some of the system level connections on the processor IO
    [Processor.sch]
2021-03-10 Wire some of the protocols
    [Processor.sch]
2021-03-10 Finished initial schematic design
    [HMIHardware.sch, Processor.sch]
2021-03-11 Clean up schematics some
    [DroneController.sch, Processor.sch, Wireless.sch]
2021-03-11 Schematic polishing
    [AudioOut.sch, ButtonInput.sch, DroneController.sch, HMIHardware.sch, JoyStick.sch, Memory.sch, PowerSupply.sch, Processor.sch]
2021-03-13 Added PCB
    [ButtonInput.sch, DroneController.kicad_pcb, DroneController.sch, HMIHardware.sch, JoyStick.sch, RotaryEncoders.sch, ToggleSW.sch]
2021-03-17 Update pcb
    [DroneController.kicad_pcb, DroneController.sch]
2021-03-18 Laid out power section
    [DroneController.kicad_pcb, PowerSupply.sch, Processor.sch, ToggleSW.sch, Wireless.sch]
2021-03-20 Lay out more PCB
    [DroneController.kicad_pcb, DroneController.sch, HMIHardware.sch, Memory.sch, PowerSupply.sch, Processor.sch, Wireless.sch]
2021-03-20 Routed most of the core peripherals
    [DroneController.kicad_pcb, DroneController.sch, Memory.sch, PowerSupply.sch, Processor.sch]
2021-03-21 Complete route of draft #1 finished
    [DroneController.kicad_pcb, HMIHardware.sch, PowerSupply.sch, Processor.sch]
2021-03-25 Finished preliminary route of PCB after design review checklist
    [DroneController.kicad_pcb, Memory.sch, PowerSupply.sch, Processor.sch, Wireless.sch]
2021-03-26 Adjust components for lowest build cost
    [DroneController-B_Cu.gbr, DroneController-B_Mask.gbr, DroneController-B_Paste.gbr, DroneController-B_SilkS.gbr, DroneController-Edge_Cuts.gbr, DroneController-F_Cu.gbr, DroneController-F_Mask.gbr, DroneController-F_Paste.gbr]
2021-03-27 HW updates. Testing out SPIFFS
    [DroneController.csv, DroneController.kicad_pcb, DroneController.sch, JoyStick.sch, PowerSupply.sch, RotaryEncoders.sch, ToggleSW.sch]
2021-04-17 Add Black Magic Probe debugger support for HW rev 1
2021-04-18 The hardware lives! An LED will blink...
2021-04-20 Remove graphics thread. Map some of the HW IO
2021-04-21 Write a simple shift register driver to control output pins
2021-04-22 Add full pin map
2021-04-22 Verified SPI interface to NRF24 on dev hardware
2021-04-22 Add test for SPI flash read/write
2021-04-24 NOR driver improvements
2021-04-25 Update the boot count file tracking to use the new Aurora binary file driver
2021-04-28 Clean up Ripple and add a task for the USB thread
2021-04-30 Add configuration of the ADC inputs (untested)
2021-05-01 Re-integrate Segger SysView. Try out ADC single channel capture (not working)
    [hmi_sticks.cpp, tsk_background.hpp, tsk_file_system.cpp, tsk_hmi.cpp, tsk_usb.cpp]
2021-05-01 Demonstrate streaming of P/R/Y/T ADC input data to registry
2021-05-09 Test out memory to memory DMA transfers
2021-05-14 Fix DMA based serial transmit
2021-05-21 Add some prototype files for the RN4871 driver
2021-05-22 Print Bluetooth version string and implement commanded reboot
    [bt_driver.cpp]
2021-05-22 Add command to set device name
2021-05-22 Add more commands to BT driver. Difficulty parsing right now.
2021-05-23 Add test plate file for F360
    [TestPlateV1.stl]
2021-05-26 Working event based rotary encoder setup
2021-05-28 GPIO/Encoder hw event input processing fully running
2021-05-28 Updated the encoder processing
2021-05-30 ADC driver fully working
2021-06-16 Begin work on transition to managed memory network driver
2021-06-26 Can pump data at high rates on the sim, but I seem to have a thread sync issue
    [tsk_radio.cpp]
2021-07-10 Finally! A working hardware net stack! Raw packets being sent wirelessly
2021-07-10 Start working on USB device driver support
2021-07-11 Investigate some USB issues. Add PCB remarks for revision 2
    [DroneController.sch, PowerSupply.sch, Processor.sch]
2021-07-17 Switch HW drivers to release builds. Pull up submodules.
2021-07-17 Route encoder rotation events through observables
2021-08-12 Address build issues for embedded target
    [tsk_radio.cpp]
2021-10-10 Save work on improvements to the bluetooth module drivers
2021-10-15 Debug bluetooth module communication issues
    [bt_driver.cpp]
2021-12-13 Improve the networking stability of RF24
    [PowerSupply.sch]
2021-12-19 Improve networking driver performance
2021-12-20 Improve network driver
2021-12-22 Start working on PCB rev 2.0
    [DroneController.kicad_pcb, DroneController.sch, HMIHardware.sch, JoyStick.sch, PowerSupply.sch, Processor.sch, RotaryEncoders.sch, ToggleSW.sch]
2021-12-22 Add more work on PCB v2 design
    [DroneController.kicad_pcb, DroneController.sch, Memory.sch, PowerSupply.sch, Processor.sch]
2021-12-27 Work further on v2.0 of controller pcb
    [DroneController.kicad_pcb, DroneController.sch, HMIHardware.sch, PowerSupply.sch, Processor.sch]
2021-12-27 Improve PCB design
    [DroneController.kicad_pcb, Processor.sch]
2021-12-30 Work on adding the i2c driver
2021-12-30 Add more of the I2C driver
    [DroneController.kicad_pcb, Processor.sch]
2021-12-31 Finish first draft of v2.0 pcb
    [ButtonInput.sch, DroneController.kicad_pcb, DroneController.sch, HMIHardware.sch, JoyStick.sch, Memory.sch, PowerSupply.sch, Processor.sch]
2022-01-01 Update I2C driver
2022-01-02 Improve i2c driver
2022-01-06 Stall work on I2C driver. EEPROM unresponsive.
    [tsk_file_system.cpp]
2022-01-10 Switch to release builds for the submodules
